project-neon/Ligeirinho/Software/Tests/DistanceSensorVL53L0X/VL53L0XConnections.png

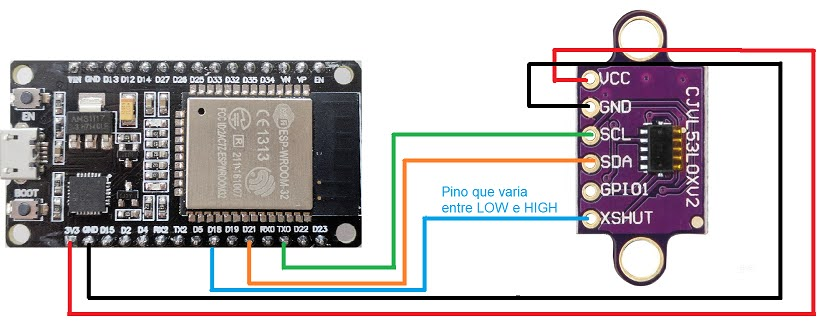
Software/Tests/DistanceSensorVL53L0X/VL53L0XConnections.png
