project-neon/Ligeirinho/README.md

# Ligeirinho
Our 4th sumo robot, Ligeirinho
