project-neon/Ligeirinho/Electronics/Como Importar a ESP32.pdf

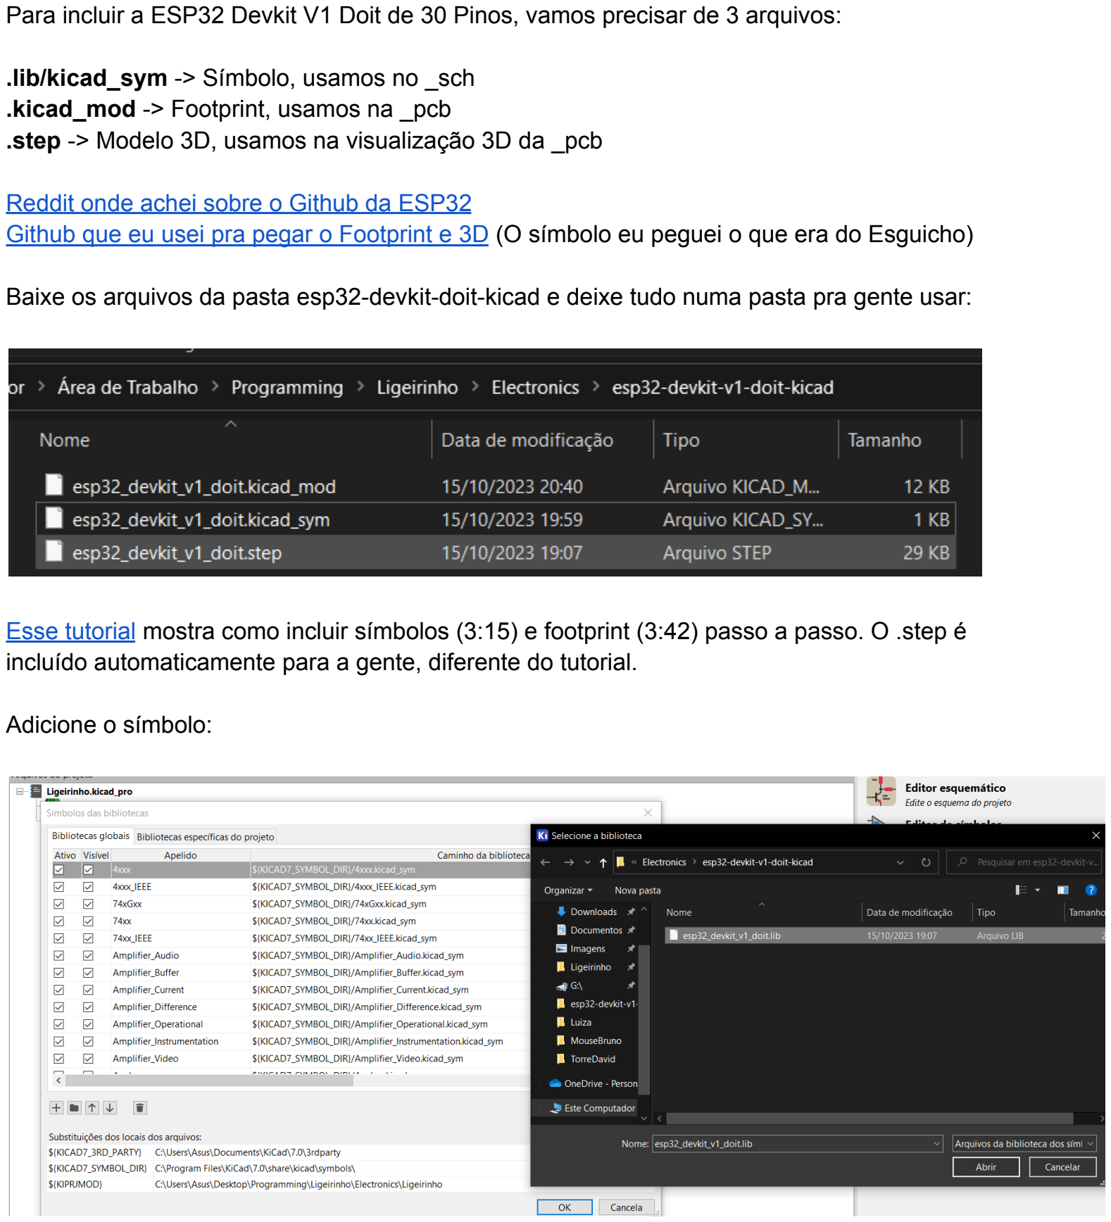
[picture p3: page 1]

Para incluir a ESP32 Devkit V1 Doit de 30 Pinos, vamos precisar de 3 arquivos:

.lib/kicad_sym -> Símbolo, usamos no _sch
.kicad_mod -> Footprint, usamos na _pcb
.step -> Modelo 3D, usamos na visualização 3D da _pcb

Reddit onde achei sobre o Github da ESP32 (https://www.reddit.com/r/esp32/comments/hufwwl/looking_for_kicad_symbolfootprint_for_esp_doit/)
Github que eu usei pra pegar o Footprint e 3D (https://gitlab.com/VictorLamoine/kicad/-/tree/master?ref_type=heads) (O símbolo eu peguei o que era do Esguicho)

Baixe os arquivos da pasta esp32-devkit-doit-kicad e deixe tudo numa pasta pra gente usar:

Esse tutorial (https://www.youtube.com/watch?v=W9cLnIjvybo&ab_channel=PlumPot) mostra como incluir símbolos (3:15) e footprint (3:42) passo a passo. O .step é incluído automaticamente para a gente, diferente do tutorial.

Adicione o símbolo:

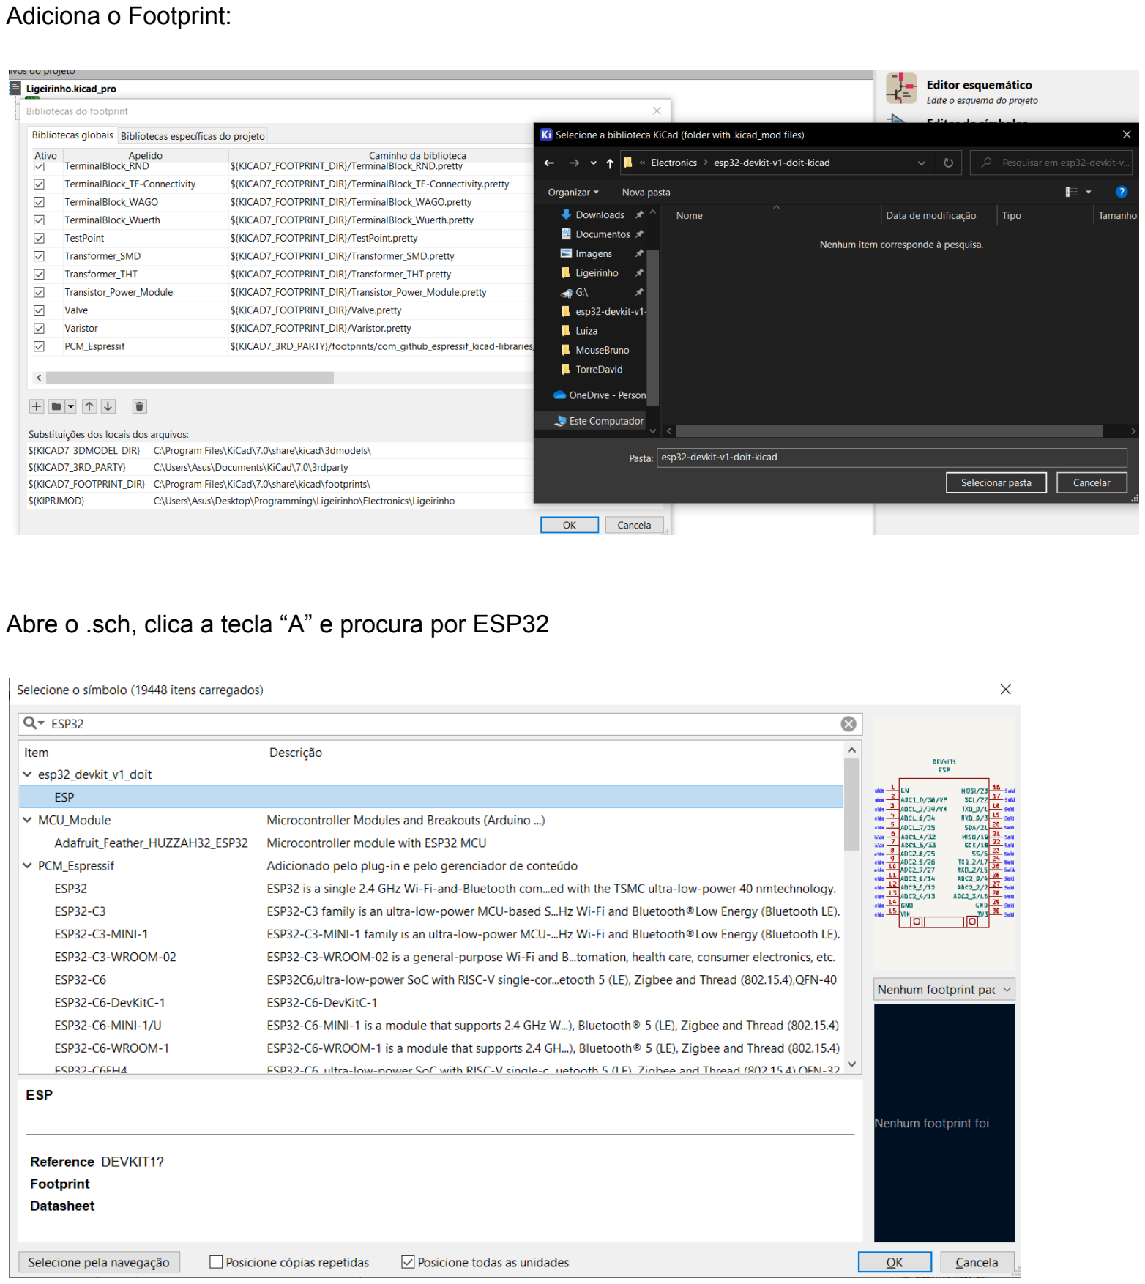
[picture p4: page 2]

Adiciona o Footprint:

Abre o .sch, clica a tecla “A” e procura por ESP32

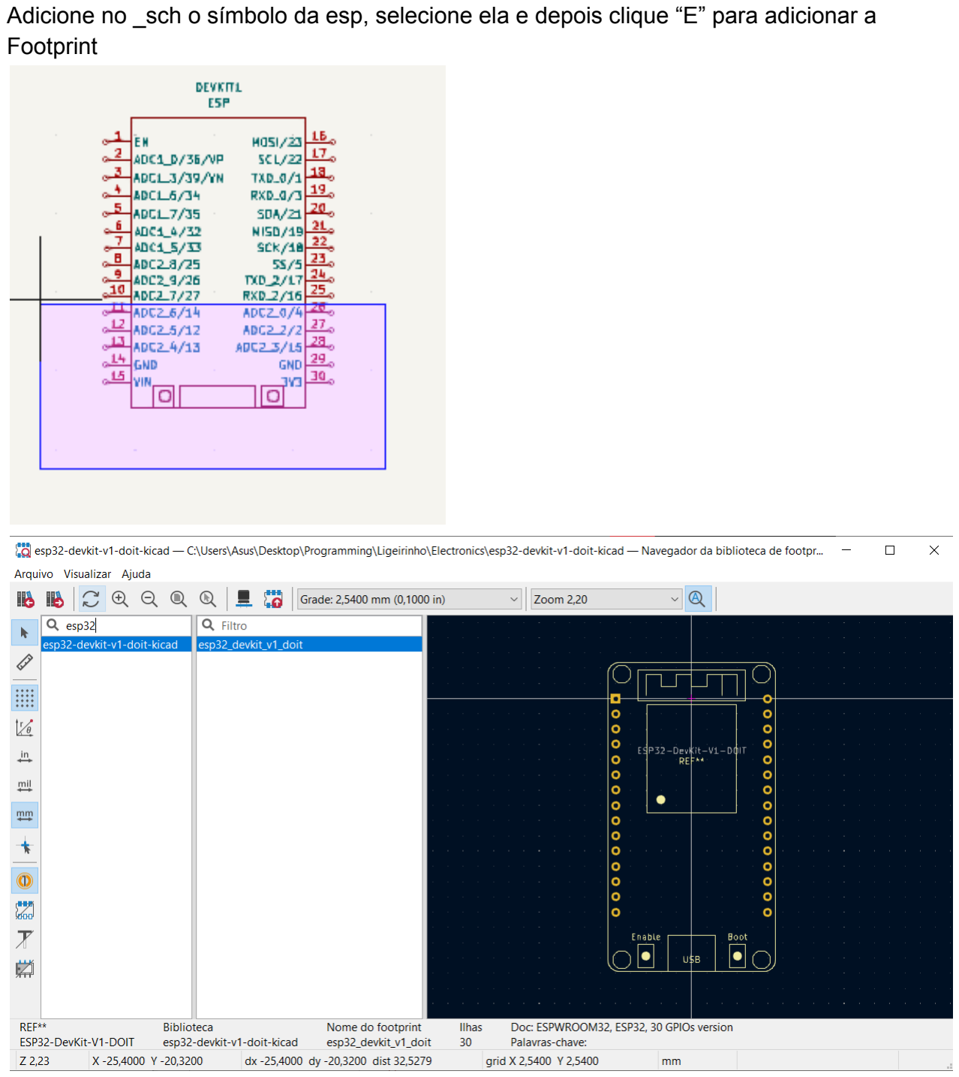
[picture p5: page 3]

A

dicio

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
p, s

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
cliq

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
dicio

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
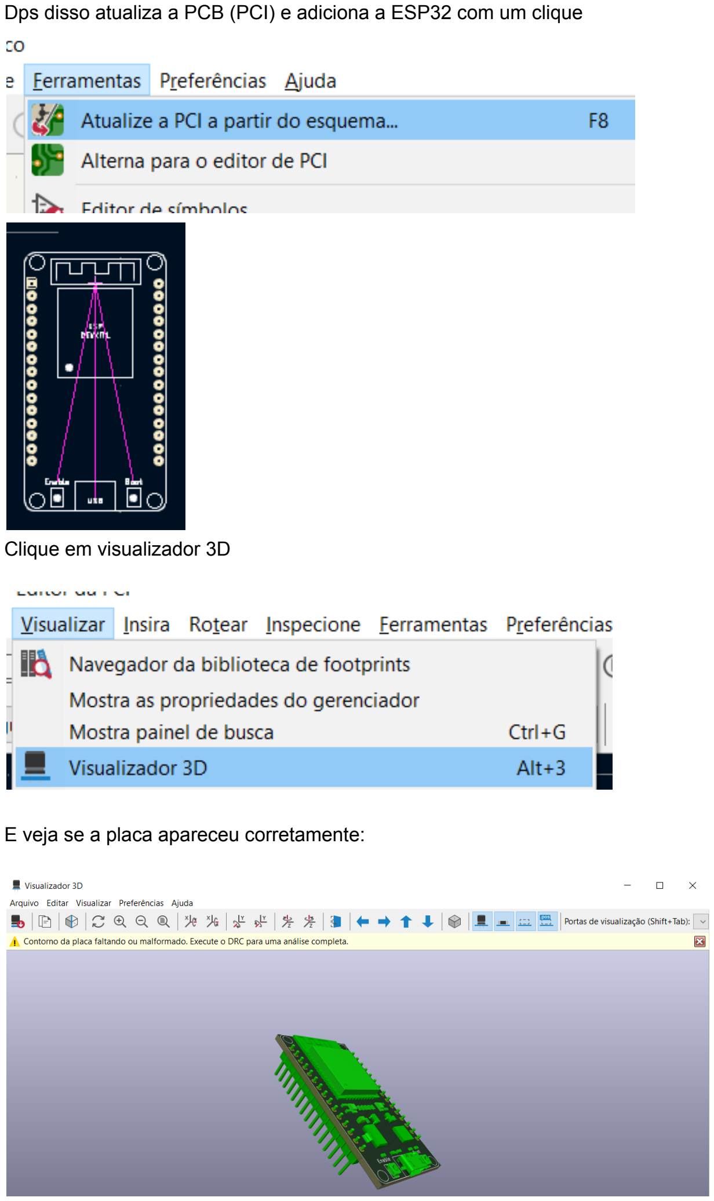
[picture p6: page 4]

Dps disso atualiza a PCB (PCI) e adiciona a ESP32 com um clique

Clique em visualizador 3D

E veja se a placa apareceu corretamente:
