project-neon/Ligeirinho/Electronics/esp32_devkit_v1_doit/esp32_devkit_v1_doit.step

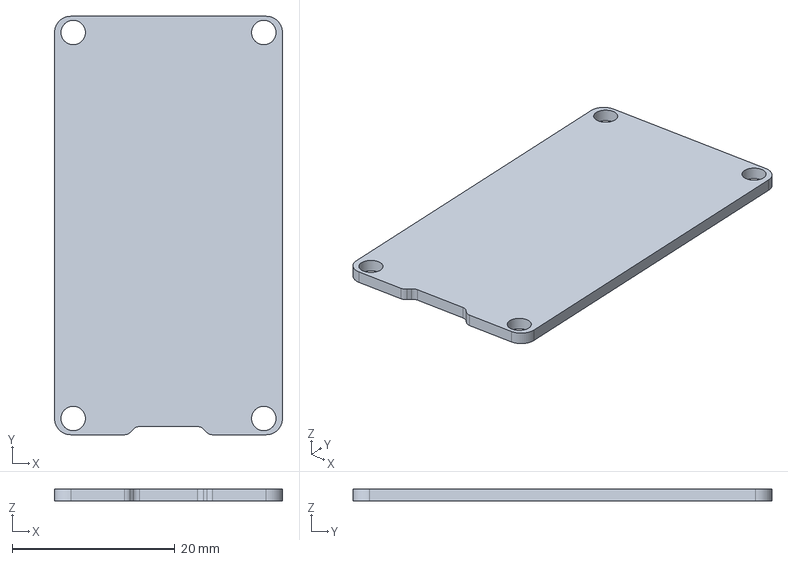
[picture p8: CAD file, 2024-04-20]
Electronics/esp32_devkit_v1_doit/esp32_devkit_v1_doit.step
28.0 x 51.4 x 1.50 mm
