project-neon/Ligeirinho/Mechanics/Chassi-Ligeirinho.stl

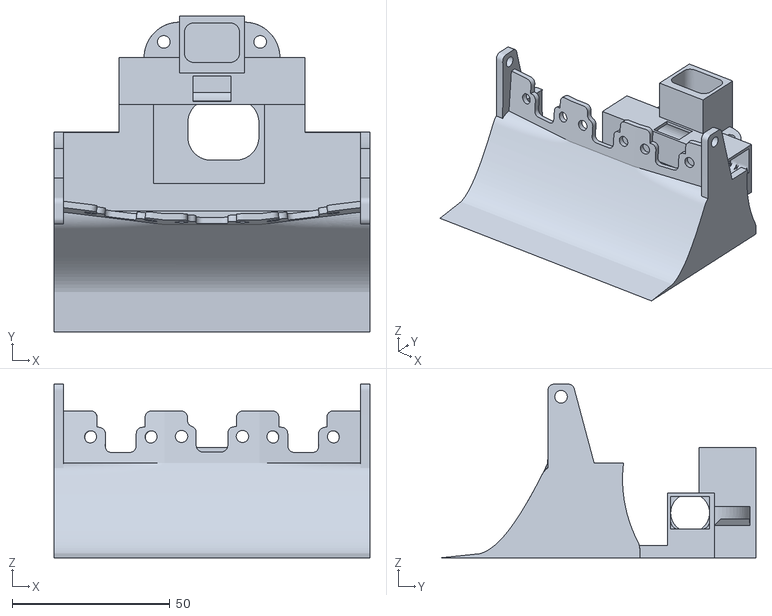
[picture p9: CAD file, 2024-05-15]
Mechanics/Chassi-Ligeirinho.stl
100.0 x 100.0 x 55.0
