project-neon/Ligeirinho/Mechanics/Hub-E-Pneu-Ligeirinho.stl

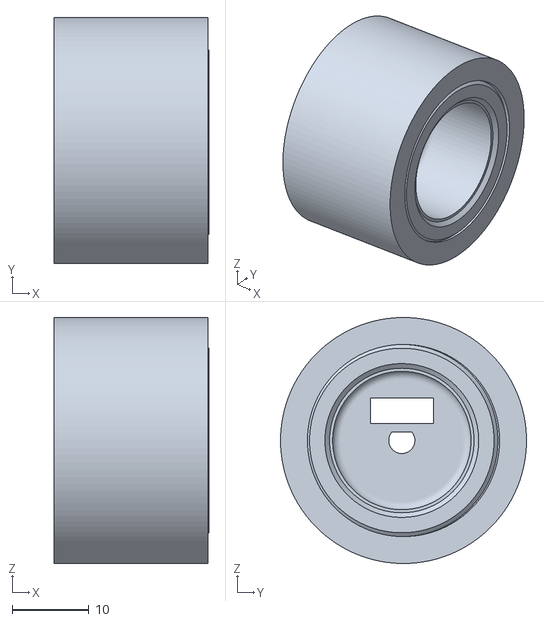
[picture p10: CAD file, 2024-05-15]
Mechanics/Hub-E-Pneu-Ligeirinho.stl
20.1 x 32.0 x 32.0
