project-neon/Ligeirinho/Mechanics/Suporte-PCB.stl

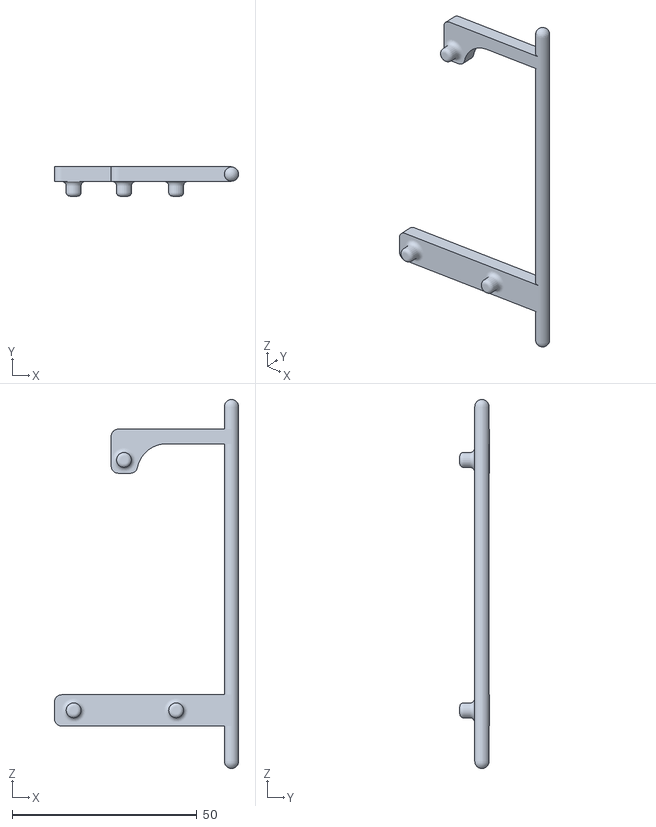
[picture p11: CAD file, 2024-05-15]
Mechanics/Suporte-PCB.stl
49.9 x 8.00 x 100.0
