project-neon/Ligeirinho/Software/Tests/GyroscopeMPU6050/MPUConnections.png

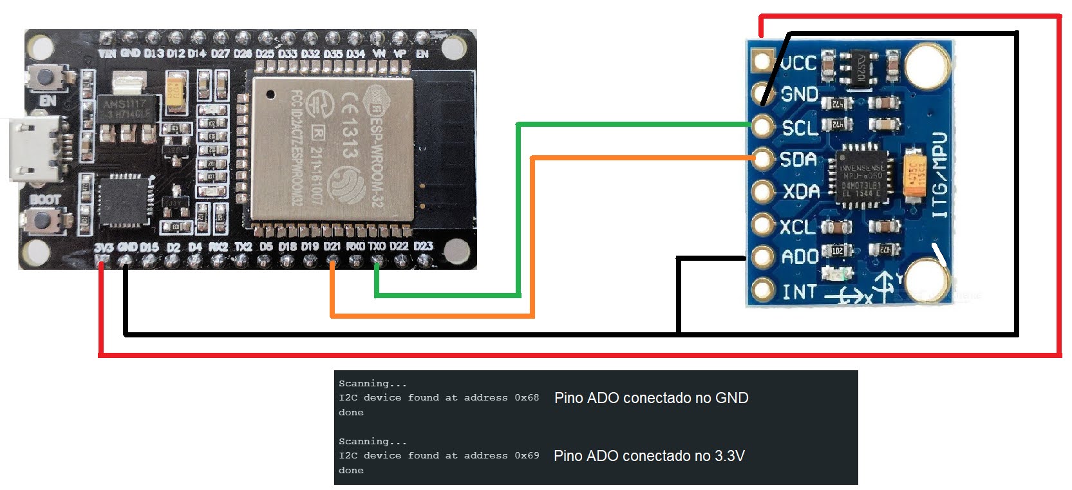
Software/Tests/GyroscopeMPU6050/MPUConnections.png
