project-neon/Ligeirinho/Software/Tests/IRJudgeControllerSensorVS1838B/IRConnections.png

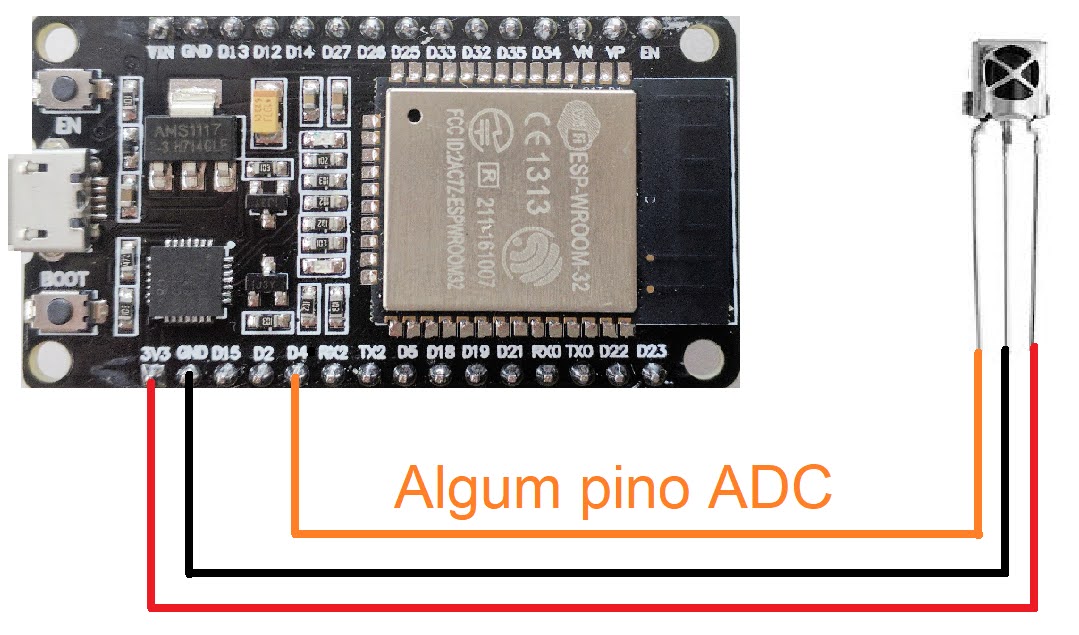
Software/Tests/IRJudgeControllerSensorVS1838B/IRConnections.png
