project-neon/Ligeirinho/Software/Tests/MotorsHBridgeDRV8833/HBridgeConnections.png

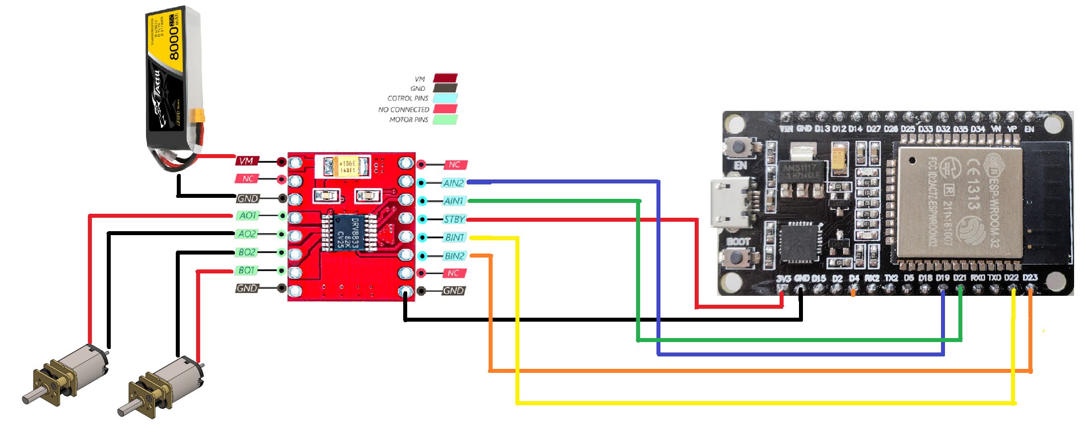
Software/Tests/MotorsHBridgeDRV8833/HBridgeConnections.png
