project-neon/Ligeirinho/Mechanics/Suporte PCB Desenho v2.pdf

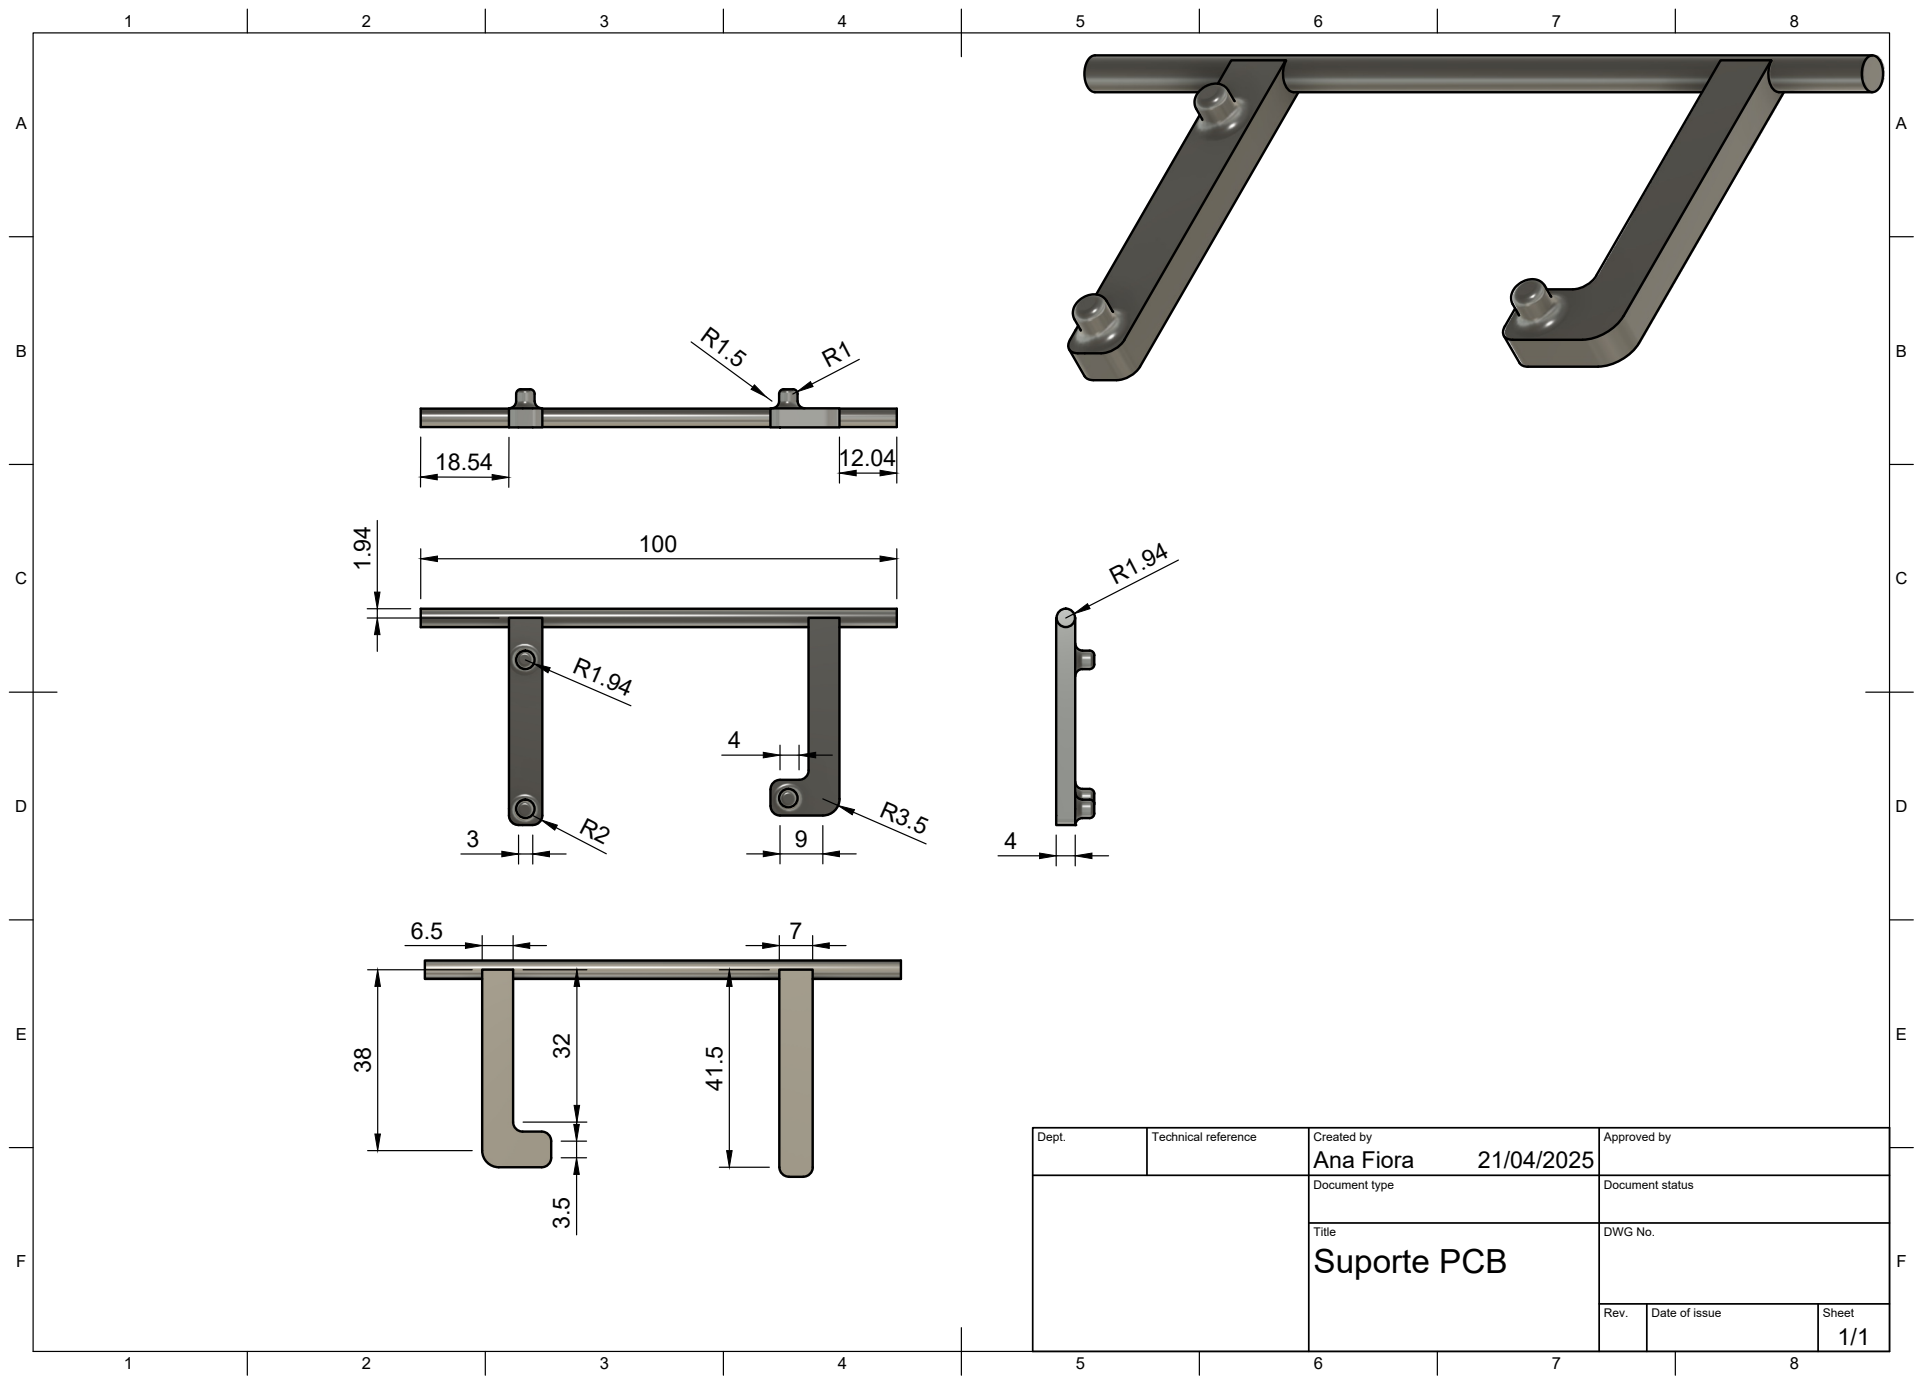
[picture p15: page 1]
Title; DWG No.; Rev.; Date of issue; Sheet; Suporte PCB

Dept. | Technical reference | Created by Ana Fiora 21/04/2025 | Approved by

Document type | Document status
