project-neon/Ligeirinho/Mechanics/Chassi Inferior Ligeirinho Desenho v13.pdf

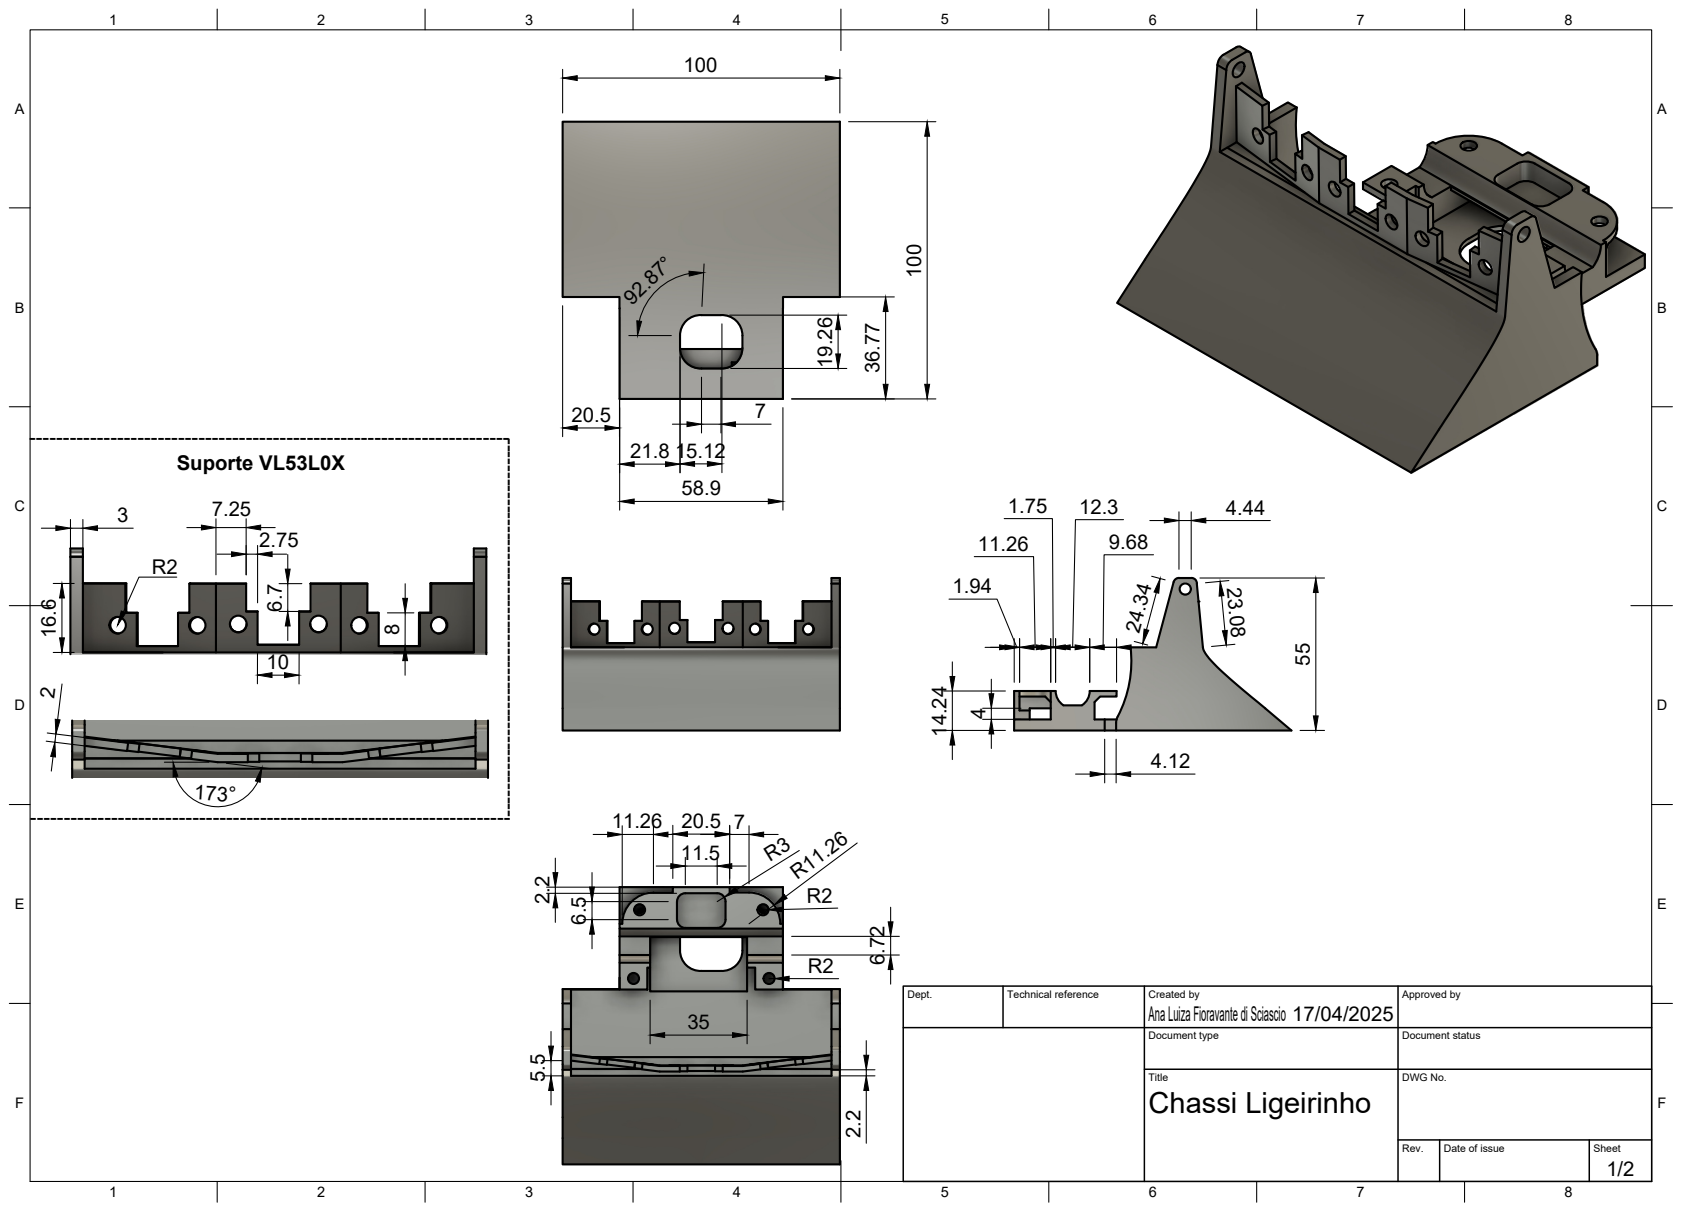
[picture p16: page 1]
Title; DWG No.; Rev.; Date of issue; Sheet; Chassi Ligeirinho; Suporte VL53L0X

Ana Luiza Fioravante di Sciascio 100

Dept. | Technical reference | Created by 17/04/2025 | Approved by

Document type | Document status

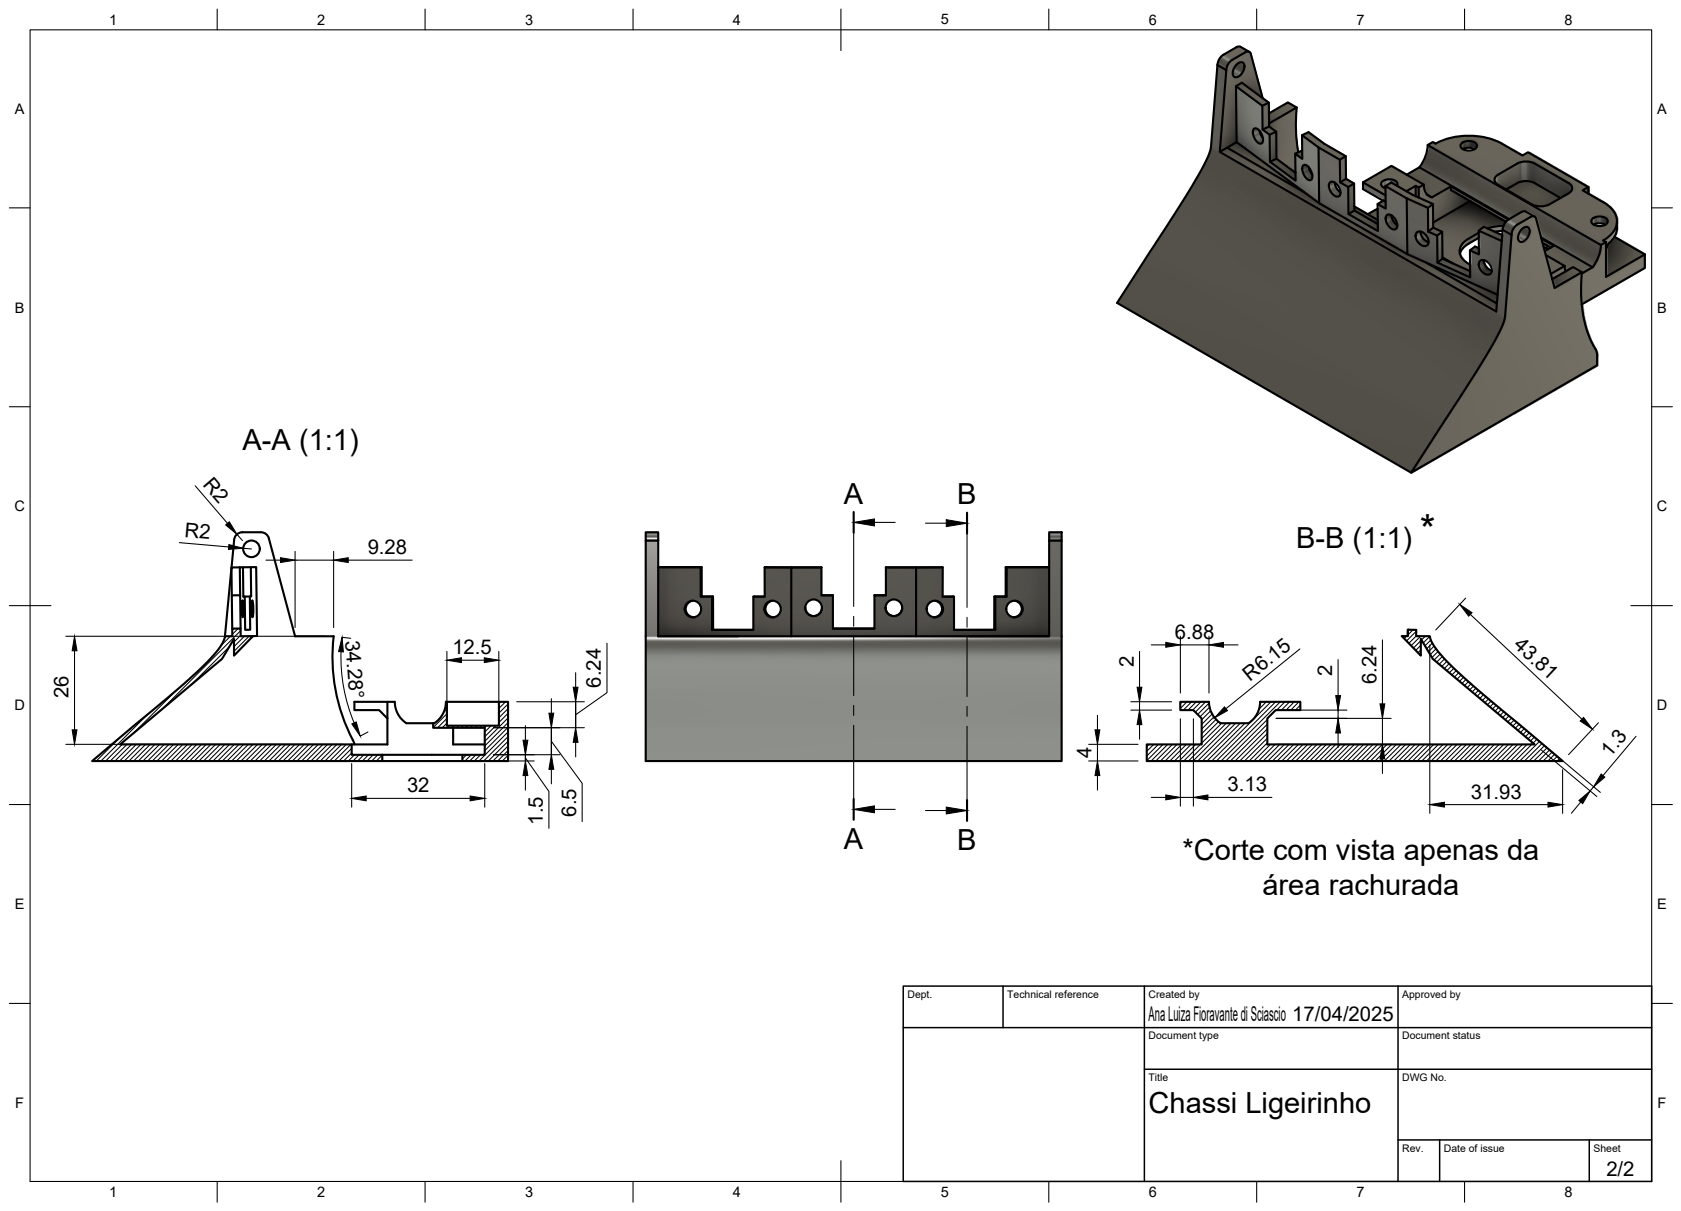
[picture p17: page 2]
Title; DWG No.; Rev.; Date of issue; Sheet; Chassi Ligeirinho

*Corte com vista apenas da
área rachurada

Dept. | Technical reference | Created by Ana Luiza Fioravante di Sciascio 17/04/2025 | Approved by

Document type | Document status
