project-neon/Ligeirinho/Mechanics/Chassi Superior Ligeirinho Desenho v2.pdf

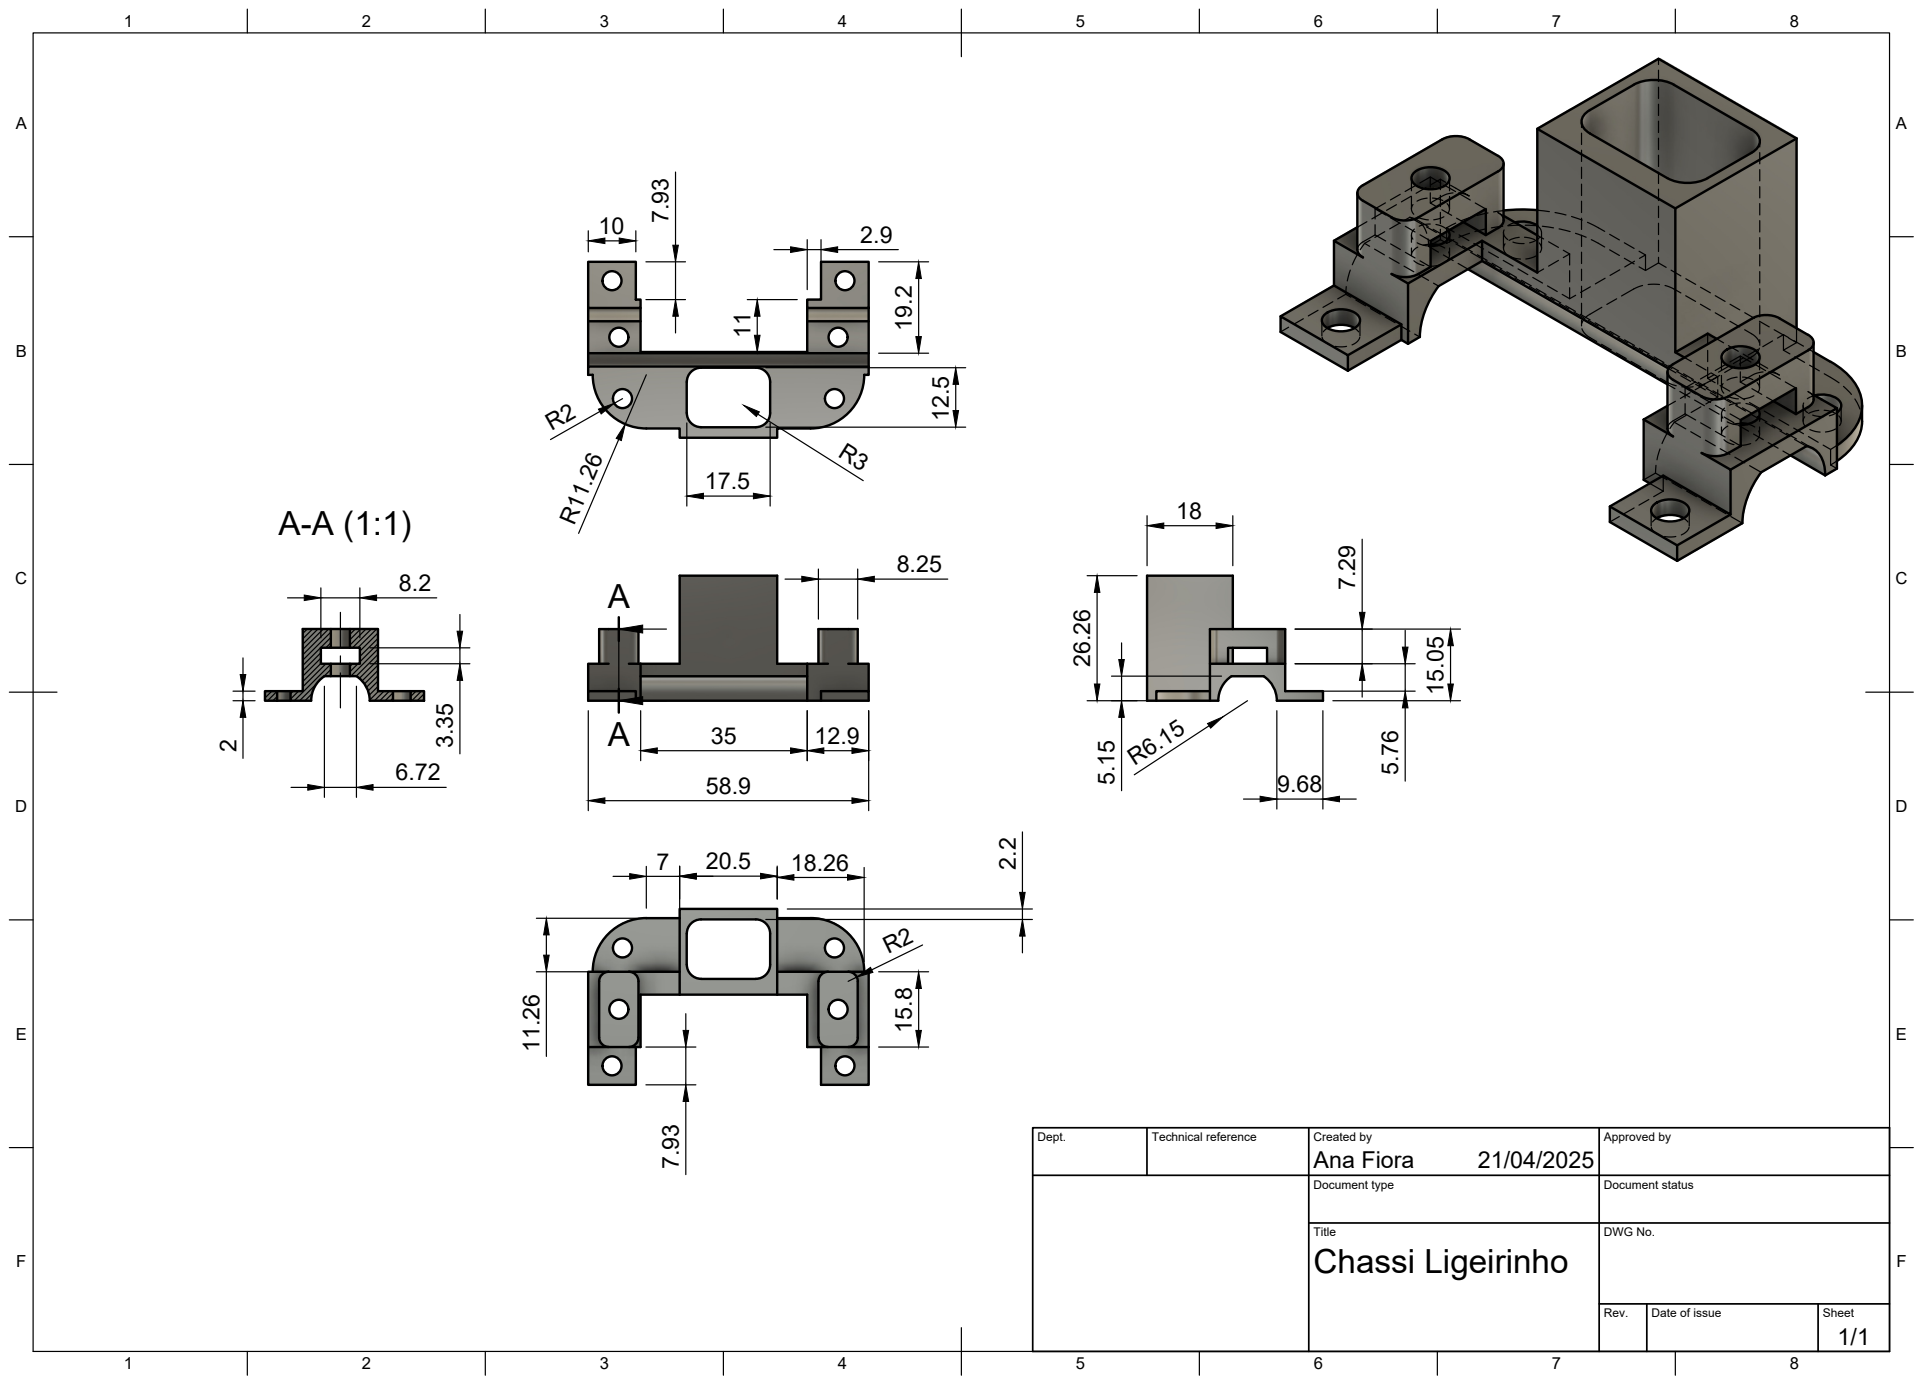
[picture p18: page 1]
Title; DWG No.; Rev.; Date of issue; Sheet; Chassi Ligeirinho; Ana Fiora 26.26

Dept. | Technical reference | Created by 21/04/2025 | Approved by

Document type | Document status
