project-neon/Ligeirinho/Mechanics/Hub Ligeirinho Desenho v1.pdf

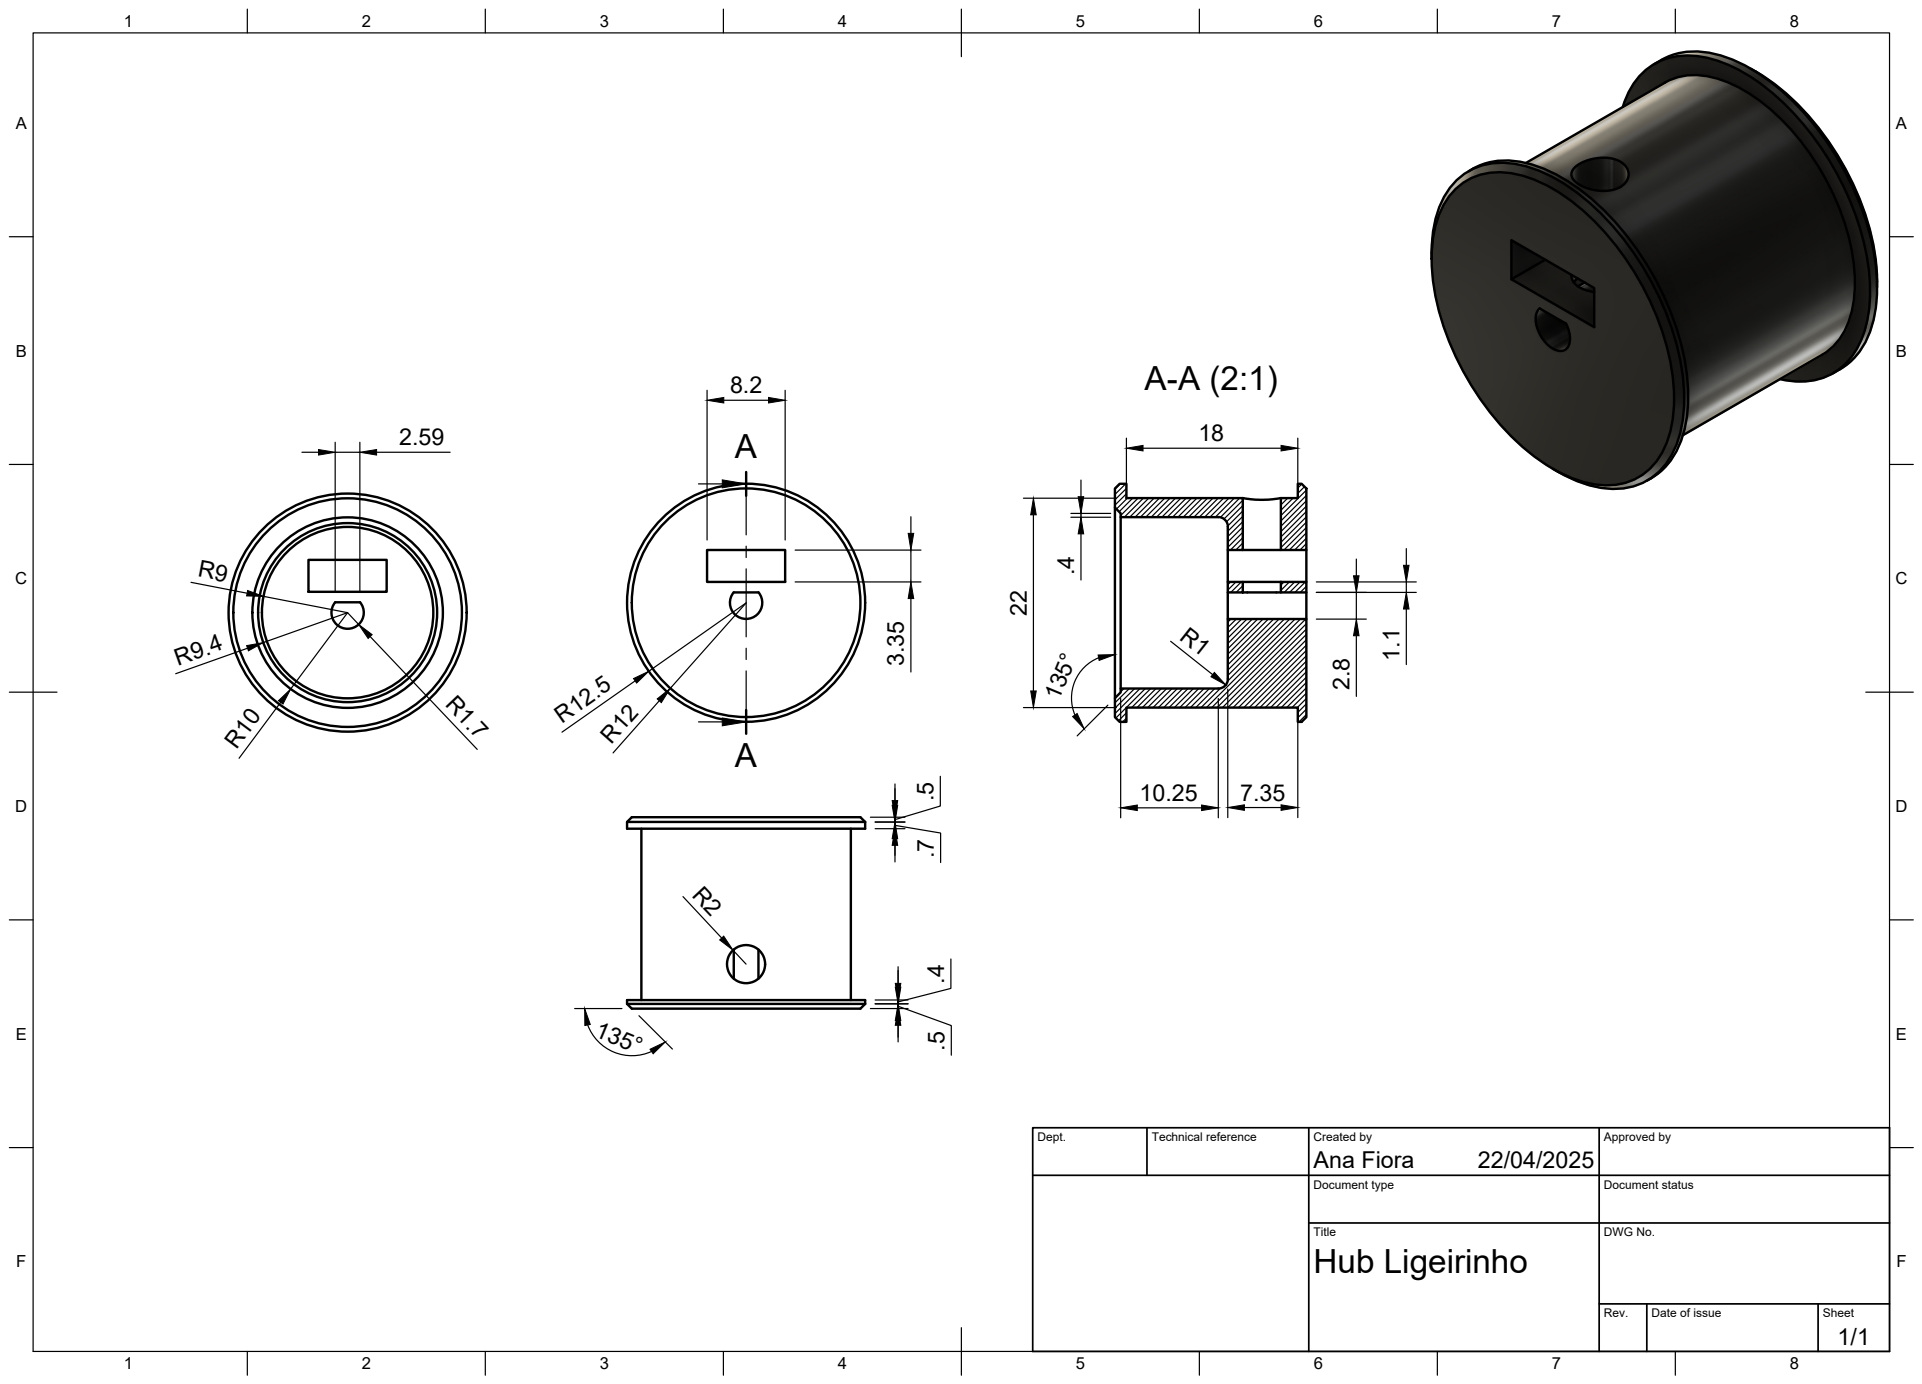
[picture p19: page 1]
Title; DWG No.; Rev.; Date of issue; Sheet; Hub Ligeirinho

Dept. | Technical reference | Created by Ana Fiora 22/04/2025 | Approved by

Document type | Document status
