project-neon/Ligeirinho/Software/Autonomous/Autonomous.ino

#include "Pinout.h"  // Arquivo com os valores dos pinos
#include "Internet.h"
#include "Constants.h"
#include "DistanceSensorVL53L0X.h"
#include "GyroscopeMPU6050.h"
#include "MotorsHBridgeDRV8833.h"
#include "MouseSensorADNS9500.h"
#include "PidController.h"
#include "IRJudgeControllerVS1838B.h"

int timer = millis();

void printDebugInfos() {
  printDistanceSensorsValues();
  printGyroscopeAngle();
  printMotorsSpeed();
  printMouseXYRelative();
  printMouseRadius();
  printPidOutput();
  Serial.print("Estratégia: " + (String) strategySelected);
  Serial.println("");
}

#if INTERNET_MODE == 1
void printInternetDebugInfos() {
  // Mostra o valor de cada sensor na tela IP/webserial
  String webSerialPrint = String("");
  webSerialPrint += printInternetDistanceSensorsValues();
  webSerialPrint += printInternetGyroscopeAngle();
  webSerialPrint += printInternetMotorsSpeed();
  webSerialPrint += printInternetMouseXYRelative();
  webSerialPrint += " Estratégia: " + (String) strategySelected;
  WebSerial.println(webSerialPrint);
  Serial.println(WiFi.localIP());
}
#endif

void setup() {
  // Inicia a comunicação serial UART
  Serial.begin(115200);

  // Inicia os motores configurando os seus canais PWM
  MotorsHBridgeDRV8833Init();
  Serial.println("Motores ON");

  #if INTERNET_MODE > 0
  // Inicia a internet
  InternetInit();
  #endif

  // Iniciar o sensor de Infra Vermelho do Juiz
  IRJudgeControllerVS1838BInit();
  Serial.println("Controle Juiz ON");

  // Inicia e endereça os 3 sensores de distância
  DistanceSensorVL53L0XInit();
  Serial.println("VL53L0X ON");

  // Inicia o sensor de mouse
  //MouseSensorADNS9500Init();
  Serial.println("Sensor Mouse ON");

}

void preventFromFalling() {
  if (radius >= maxRadius) {
    velMotorL = velMotorR = -40;
    sendPWMToMotors();
    delay(200);
  }
}

void simpleStrategy() {
  if (distC < distAtk and (distL < distAtk or distR < distAtk)) {
    Serial.print("ATACANDO \t\t");
    // preventFromFalling();
    velMotorL = velMotorR = speedStandard;
  } else if (distL < distAtk or distR < distAtk) {
    (distL < distAtk) ? Serial.print("ESQ \t\t") : Serial.print("DIR \t\t");
    // preventFromFalling();
    velMotorL = (distL < distAtk) ? speedStandard * 0.9 : speedStandard;
    velMotorR = (distL < distAtk) ? speedStandard : speedStandard * 0.9;
    enemyLastTimeSeenLeft = (distL < distAtk) ? true : false;
  } else {
    enemyLastTimeSeenLeft ? Serial.print("PROCURANDO ESQ \t\t") : Serial.print("PROCURANDO DIR \t\t");
    velMotorL = enemyLastTimeSeenLeft ? -searchSpeed : searchSpeed;
    velMotorR = enemyLastTimeSeenLeft ? searchSpeed : -searchSpeed;
  }
}

void goBackAndForth() {
  calculatePidAngleError();
  if (radius <= minRadius) canRevertVel = true;
  if (radius >= maxRadius && canRevertVel) {
    speedStandard = -speedStandard;
    canRevertVel = false;
  }
  velMotorL = constrain(speedStandard + pidOutput, -100, 100);
  velMotorR = constrain(speedStandard - pidOutput, -100, 100);
}

void notMoveYAxis() {
  calculatePidYAxisError();
  velMotorL = constrain(-pidOutput, -100, 100);
  velMotorR = constrain(-pidOutput, -100, 100);
}

void checkIfBeingPushed() {
  for (int i = 0; i < (9); i++) listXDistanceValues[i] = listXDistanceValues[i + 1];
  listXDistanceValues[9] = dx;

  int sum = 0;
  for (int i = 0; i < 10; i++) sum += listXDistanceValues[i];
  int meanValueXDistance = sum / 10;
  // Serial.println(meanValueXDistance);
  if (meanValueXDistance >= 400) velMotorL = velMotorR = -maxSpeed;
  else if (distL < distAtk/3 || distC < distAtk/3 || distR < distAtk/3) velMotorL = velMotorR = maxSpeed;
}

void loop() {

  // Checa se recebemos algum comando do controle do Juiz e muda de estágio
  checkSensorIR();

  readDistanceSensorsValues();
  readGyroscopeAngles();
  readMouseXY();
  updateRobotRadius();
  

  if (isRobotAllowedToMove) {
    simpleStrategy();
    // goBackAndForth();
    // checkIfBeingPushed();
    // notMoveYAxis();
  } else {
    velMotorL = velMotorR = 0;
  }

  sendPWMToMotors();
  printDebugInfos();

  #if INTERNET_MODE == 1
  if (millis() - timer >= 200) {
    timer = millis();
    printInternetDebugInfos();
  }
  #endif
}
