project-neon/Ligeirinho/Software/Autonomous/Constants.h

const int distAtk = 600;
int speedStandard = 100;
const int maxSpeed = 100;
const int searchSpeed = 50;
const int maxRadius = 1500;
// const int maxRadius = 14500;//Dohyou
const int minRadius = maxRadius-500;
bool canRevertVel = false;

// Registers
#define REG_Product_ID                           0x00
#define REG_Revision_ID                          0x01
#define REG_Motion                               0x02
#define REG_Delta_X_L                            0x03
#define REG_Delta_X_H                            0x04
#define REG_Delta_Y_L                            0x05
#define REG_Delta_Y_H                            0x06
#define REG_SQUAL                                0x07
#define REG_Pixel_Sum                            0x08
#define REG_Maximum_Pixel                        0x09
#define REG_Minimum_Pixel                        0x0a
#define REG_Shutter_Lower                        0x0b
#define REG_Shutter_Upper                        0x0c
#define REG_Frame_Period_Lower                   0x0d
#define REG_Frame_Period_Upper                   0x0e
#define REG_Configuration_I                      0x0f
#define REG_Configuration_II                     0x10
#define REG_Frame_Capture                        0x12
#define REG_SROM_Enable                          0x13
#define REG_Run_Downshift                        0x14
#define REG_Rest1_Rate                           0x15
#define REG_Rest1_Downshift                      0x16
#define REG_Rest2_Rate                           0x17
#define REG_Rest2_Downshift                      0x18
#define REG_Rest3_Rate                           0x19
#define REG_Frame_Period_Max_Bound_Lower         0x1a
#define REG_Frame_Period_Max_Bound_Upper         0x1b
#define REG_Frame_Period_Min_Bound_Lower         0x1c
#define REG_Frame_Period_Min_Bound_Upper         0x1d
#define REG_Shutter_Max_Bound_Lower              0x1e
#define REG_Shutter_Max_Bound_Upper              0x1f
#define REG_LASER_CTRL0                          0x20
#define REG_Observation                          0x24
#define REG_Data_Out_Lower                       0x25
#define REG_Data_Out_Upper                       0x26
#define REG_SROM_ID                              0x2a
#define REG_Lift_Detection_Thr                   0x2e
#define REG_Configuration_V                      0x2f
#define REG_Configuration_IV                     0x39
#define REG_Power_Up_Reset                       0x3a
#define REG_Shutdown                             0x3b
#define REG_Inverse_Product_ID                   0x3f
#define REG_Motion_Burst                         0x50
#define REG_SROM_Load_Burst                      0x62
#define REG_Pixel_Burst                          0x64

int MHz = 1000000;

// Firmware "adns9800_srom_A4.txt" from
// This firmware is Copyright Avago, please refer to them concerning modifications.
const unsigned short firmware_length = 3070;

const unsigned char firmware_data[firmware_length] PROGMEM = {
0x03, 0xa4, 0x6e, 0x16, 0x6d, 0x89, 0x3e, 0xfe, 0x5f, 0x1c, 0xb8, 0xf2, 0x47, 0x0c, 0x7b,
0x74, 0x6a, 0x56, 0x0f, 0x7d, 0x76, 0x71, 0x4b, 0x0c, 0x97, 0xb6, 0xcf, 0xfd, 0x78, 0x72,
0x66, 0x2f, 0xbd, 0xf8, 0x53, 0x24, 0xab, 0xd4, 0x2c, 0xb0, 0xe4, 0x32, 0xf1, 0x6a, 0x56,
0x2e, 0xbf, 0xfc, 0x7a, 0x57, 0x0d, 0x79, 0x70, 0x66, 0x46, 0x0e, 0x7f, 0x5d, 0x19, 0x91,
0xaa, 0xc2, 0x0d, 0x8e, 0x7f, 0x5d, 0x19, 0xb0, 0xe2, 0x46, 0xef, 0x5c, 0x3a, 0xd7, 0x2c,
0xbb, 0xf4, 0x6a, 0x37, 0xcd, 0x18, 0xb2, 0xc7, 0x0c, 0x9a, 0x97, 0x8f, 0x52, 0xfd, 0x0d,
0xb8, 0x41, 0x00, 0x9e, 0x8e, 0x9a, 0x1e, 0x6d, 0x0c, 0xe2, 0xaa, 0x13, 0x93, 0xb8, 0xc1,
0x2a, 0x29, 0xbb, 0x0b, 0xe3, 0x71, 0x08, 0x6d, 0xfd, 0xb6, 0xd9, 0xcf, 0x65, 0x21, 0x27,
0x45, 0x1b, 0xbe, 0xe2, 0x61, 0x86, 0x3c, 0xbf, 0x68, 0x9c, 0xd6, 0x75, 0x01, 0x5e, 0xe0,
0xc6, 0x92, 0x79, 0xf4, 0x6a, 0xa9, 0xbb, 0x2a, 0x79, 0xd0, 0xe1, 0x5c, 0x32, 0xb1, 0x5a,
0x1b, 0xba, 0xaf, 0x11, 0xea, 0x24, 0x6a, 0x83, 0x4f, 0x8d, 0xed, 0x19, 0x62, 0x70, 0x54,
0xfb, 0x0e, 0x1f, 0x83, 0xcc, 0xf0, 0xb7, 0xae, 0x05, 0xd3, 0x42, 0x5d, 0x48, 0xa0, 0x7a,
0x0b, 0x73, 0xb3, 0xc8, 0xa6, 0xb7, 0x1b, 0x08, 0x13, 0x9b, 0x89, 0x44, 0x42, 0xae, 0xd8,
0x6a, 0xba, 0x9b, 0x84, 0x25, 0x8b, 0xa4, 0x5e, 0x0b, 0x85, 0xb0, 0x8f, 0x8d, 0x80, 0x9c,
0xd1, 0x52, 0xc7, 0xcb, 0xff, 0x8d, 0x8b, 0xdd, 0x87, 0xf2, 0x63, 0xca, 0xe7, 0x4f, 0x4a,
0x57, 0x3c, 0xdf, 0xaf, 0xcb, 0x5c, 0xbb, 0x39, 0x0b, 0x01, 0x9c, 0x79, 0x22, 0x15, 0xb8,
0xa0, 0xd3, 0x72, 0x02, 0x35, 0x20, 0x40, 0xe0, 0x17, 0xde, 0x89, 0x88, 0xce, 0xe9, 0x2b,
0x75, 0xba, 0xa0, 0x96, 0x24, 0x1e, 0x71, 0xb5, 0x15, 0x00, 0x61, 0xe0, 0x5c, 0x93, 0x4e,
0xea, 0x53, 0xd0, 0xfc, 0xef, 0xae, 0x2b, 0xeb, 0x8f, 0xc7, 0x69, 0x68, 0xc7, 0xfc, 0x1a,
0x1f, 0x41, 0x0d, 0xd0, 0xc1, 0x03, 0xaf, 0xc9, 0xfd, 0xe4, 0x21, 0x43, 0xc4, 0xef, 0xc2,
0xdd, 0x7b, 0x73, 0xbc, 0xca, 0xf4, 0xa5, 0x2e, 0x83, 0x90, 0x1f, 0x78, 0x41, 0xc3, 0x13,
0x8e, 0x95, 0x0a, 0x57, 0xdf, 0x0a, 0x87, 0x40, 0x2b, 0xd9, 0xba, 0x56, 0x59, 0x9d, 0x2c,
0xb2, 0xb8, 0xb3, 0xfb, 0x77, 0x78, 0x3a, 0xef, 0xbf, 0x2d, 0xc8, 0xb9, 0x94, 0x62, 0x47,
0x92, 0x98, 0x42, 0x23, 0x07, 0xd9, 0x39, 0x46, 0x5e, 0x6f, 0xe0, 0x46, 0x14, 0x0e, 0x3d,
0x74, 0x40, 0x21, 0xb4, 0x67, 0x05, 0xa8, 0xe2, 0x12, 0x93, 0x41, 0xc2, 0x80, 0xb9, 0x56,
0x4b, 0xf9, 0x5a, 0x15, 0x9c, 0x37, 0xc4, 0x4b, 0x05, 0xad, 0x5a, 0xaf, 0xa1, 0x3e, 0xe4,
0x6e, 0xc5, 0x91, 0xb6, 0x75, 0x7d, 0x1b, 0xe4, 0xc5, 0x4d, 0x28, 0x6b, 0xe9, 0xad, 0x20,
0x8b, 0x64, 0x91, 0x57, 0x4f, 0xdf, 0x9a, 0x97, 0x7e, 0xbe, 0x8e, 0xd6, 0xd6, 0x3b, 0x17,
0xf9, 0x19, 0x28, 0xb2, 0x2e, 0x8f, 0x26, 0xb4, 0x9b, 0xe5, 0xde, 0x0f, 0x8d, 0x0a, 0x9a,
0x9d, 0x1b, 0xde, 0x6f, 0xcb, 0x84, 0xba, 0x26, 0xd0, 0x12, 0xef, 0x30, 0x38, 0x43, 0xac,
0xb7, 0xa7, 0xef, 0x09, 0x7c, 0x52, 0x27, 0xfc, 0x2e, 0xab, 0x50, 0xa0, 0x21, 0x40, 0xe7,
0xc1, 0x5f, 0x02, 0x41, 0x84, 0xa8, 0x54, 0xa8, 0x2e, 0x37, 0x6f, 0xd8, 0xb1, 0xa4, 0xd0,
0x75, 0xef, 0x31, 0xca, 0x54, 0x1e, 0x33, 0xad, 0x19, 0xa1, 0x94, 0xbc, 0x1b, 0x34, 0x6c,
0xfb, 0x5f, 0xcc, 0x45, 0x76, 0xc8, 0x96, 0xce, 0x1c, 0x3a, 0x0e, 0x77, 0xed, 0xd8, 0xd2,
0x96, 0xac, 0x77, 0x30, 0xe1, 0xef, 0xb0, 0x33, 0xf0, 0x6e, 0x3d, 0xce, 0x5e, 0x6d, 0xde,
0x8a, 0xdc, 0x9b, 0x91, 0x63, 0x2a, 0x95, 0x20, 0x0d, 0xfd, 0x78, 0xba, 0xcb, 0x15, 0x43,
0xc9, 0x20, 0x96, 0x83, 0x06, 0xd9, 0x11, 0xf3, 0xe2, 0x13, 0xcf, 0x9c, 0x91, 0x7f, 0x33,
0x46, 0xa7, 0xe2, 0xd3, 0x75, 0xff, 0x4f, 0x0c, 0x0c, 0xaf, 0xcd, 0xa6, 0x9c, 0xa6, 0x73,
0xe2, 0x6d, 0x17, 0x16, 0xb5, 0x99, 0x80, 0x35, 0xd9, 0x61, 0xf3, 0x48, 0x23, 0xff, 0xae,
0x53, 0x89, 0xfa, 0x55, 0x1c, 0x37, 0xa5, 0xe8, 0x62, 0x12, 0xb2, 0x22, 0x04, 0xed, 0x42,
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
};
