project-neon/Ligeirinho/(commit log)

2023-10-03 test: add MPU6050, VL53L0X and I2C Scan tests
2023-10-16 feat(Electronics): add ESP32 symbol, Footprint and 3D
    [esp32_devkit_v1_doit.step]
2023-10-18 test: add Judge IR controller sensor test
2023-10-18 test: add motors test
2023-12-28 chore: add electronic repository of ligerinho
    [ligeirinho.kicad_pcb, ligeirinho.kicad_sch]
2023-12-28 shore: update electronic repository
    [ligeirinho.kicad_sch]
2023-12-29 shore: organized tags, add footprints and esp32 schematic
    [ligeirinho.kicad_sch]
2024-01-13 shore: update PCB repository
    [ligeirinho.kicad_pcb, ligeirinho.kicad_sch]
2024-01-15 shore: add stickers
    [ligeirinho.kicad_pcb]
2024-01-16 shore: add measures
    [ligeirinho.kicad_pcb]
2024-01-16 fix(Electronics): add VIN tag to PCB
    [ligeirinho.kicad_pcb]
2024-01-17 fix: add 10uF capacitors and stitching
    [ligeirinho.kicad_pcb]
2024-01-17 add: AMS1117 to 3v3 regulator
    [ligeirinho.kicad_pcb, ligeirinho.kicad_sch]
2024-01-17 fix: add some more stitching GND holes
    [ligeirinho.kicad_pcb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]
2024-01-23 chore: add mouse sensor to pcb and fix some measures
    [ligeirinho+placasSensorMouse.kicad_pcb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]
2024-01-23 fix: change pcb size from 76mm to 77mm
    [ligeirinho.kicad_pcb]
2024-02-07 test: add mouse test prototype
2024-02-29 feat: add autonomous stategy
    [ligeirinho.kicad_pcb, ligeirinho.kicad_sch]
2024-03-01 fix: absolute value x and y
    [Autonomous.ino, MouseSensorADNS9500.h]
2024-03-13 fix(IRSensor): fix to Sony controller values
    [IRJudgeControllerSensorVS1838B.ino, IRJudgeControllerVS1838B.h]
2024-03-13 fix: change I2C speed comm to 400kHz
    [DistanceSensorVL53L0X.h, GyroscopeMPU6050.h]
2024-03-13 fix: motorsOutput() mistype
2024-03-13 feat: start using mouse sensor to control the robot
2024-03-16 feat: add PID to controll the robot
2024-03-21 feat: add new PD controller to y axis
2024-05-15 feat: add mechanical files
    [Chassi-Ligeirinho.stl, Hub-E-Pneu-Ligeirinho.stl, Suporte-PCB.stl]
2024-05-18 chore: init modular PCB
    [Sumo_Geral_Modular.kicad_pcb, Sumo_Geral_Modular.kicad_sch]
2024-06-01 chore: continue development modular pcb
    [Sumo_Geral_Modular.kicad_sch]
2024-06-15 chore: finish the schematic and set footprints
    [Sumo_Geral_Modular.kicad_sch]
2024-06-15 chore: set all footprints
    [Sumo_Geral_Modular.kicad_pcb, Sumo_Geral_Modular.kicad_sch]
2024-07-13 shore: update PCB
    [Sumo_Geral_Modular.kicad_pcb, Sumo_Geral_Modular.kicad_sch, dory.kicad_pcb, dory.kicad_sch]
2024-08-31 shore: PCB review
    [Sumo_Geral_Modular.kicad_pcb, Sumo_Geral_Modular.kicad_sch]
2024-09-14 shore: schematic final review
    [Sumo_Geral_Modular.kicad_pcb, Sumo_Geral_Modular.kicad_sch]
2024-09-14 chore(Electronics): new symbols and footprints
    [Sumo_Geral_Modular.kicad_sch, esp32_devkit_v1_doit.step]
2024-09-16 chore: Add/Update 3D models on PCB
    [Sumo_Geral_Modular.kicad_pcb, Sumo_Geral_Modular.kicad_sch]
2024-11-20 chore: schamatic review
    [Sumo_Geral_Modular.kicad_sch]
2024-11-20 chore: change PCB size
    [Sumo_Geral_Modular.kicad_pcb]
2024-11-21 chore: finish PCB V1
    [Sumo_Geral_Modular.kicad_pcb, Sumo_Geral_Modular.kicad_sch]
2024-11-21 chore: application of DRC and error correction
    [Sumo_Geral_Modular.kicad_pcb]
2024-12-04 chore: update PCB and schematic
    [Sumo_Geral_Modular.kicad_pcb, Sumo_Geral_Modular.kicad_sch]
2024-12-04 chore: update resistors values
    [Sumo_Geral_Modular.kicad_pcb, Sumo_Geral_Modular.kicad_sch]
2024-12-17 chore: create GERBER file
    [Sumo_Geral_Modular-B_Cu.gbr, Sumo_Geral_Modular-B_Mask.gbr, Sumo_Geral_Modular-B_Paste.gbr, Sumo_Geral_Modular-B_Silkscreen.gbr, Sumo_Geral_Modular-Edge_Cuts.gbr, Sumo_Geral_Modular-F_Cu.gbr, Sumo_Geral_Modular-F_Mask.gbr, Sumo_Geral_Modular-F_Paste.gbr]
2025-02-01 chore: add strategies buttons, fix motors & pins, add strategy internet
    [Autonomous.ino, GyroscopeMPU6050.h, IRJudgeControllerVS1838B.h, Internet.h, MotorsHBridgeDRV8833.h, Pinout.h]
2025-09-08 docs(Electronics): fix folders so that modular PCB is in Electronics
    [Sumo_Geral_Modular-B_Cu.gbr, Sumo_Geral_Modular-B_Mask.gbr, Sumo_Geral_Modular-B_Paste.gbr, Sumo_Geral_Modular-B_Silkscreen.gbr, Sumo_Geral_Modular-Edge_Cuts.gbr, Sumo_Geral_Modular-F_Cu.gbr, Sumo_Geral_Modular-F_Mask.gbr, Sumo_Geral_Modular-F_Paste.gbr]
